connorwhite-online/touch-mic/hardware/renders/gummy-top.png

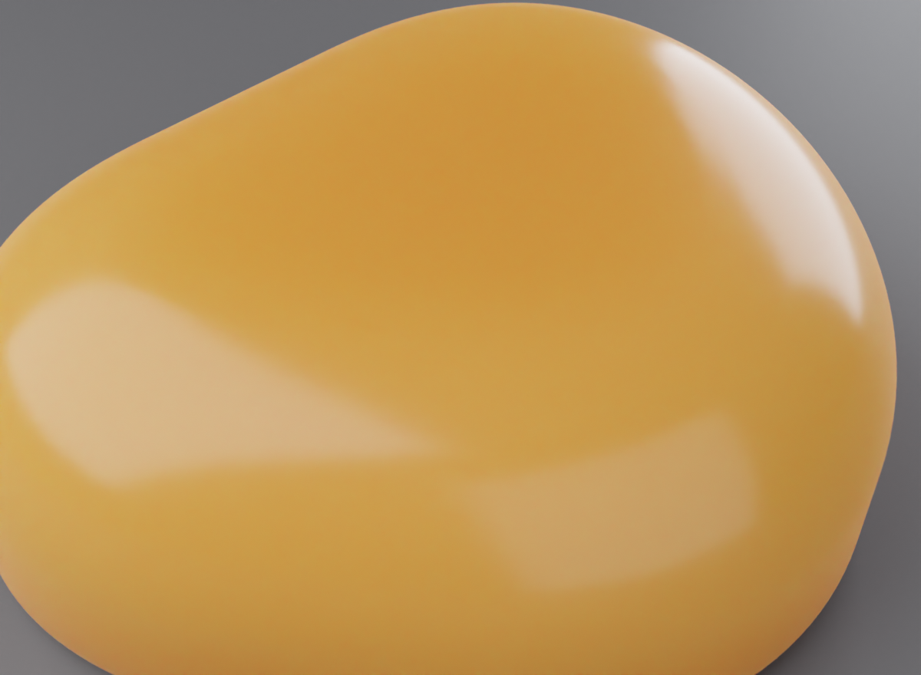
hardware/renders/gummy-top.png
