connorwhite-online/touch-mic/hardware/renders/pad-iso.png

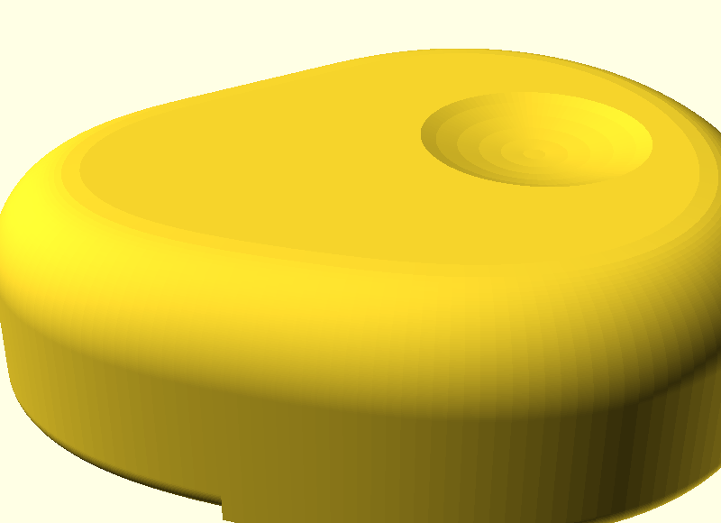
hardware/renders/pad-iso.png
