connorwhite-online/touch-mic/hardware/renders/gummy-hero.png

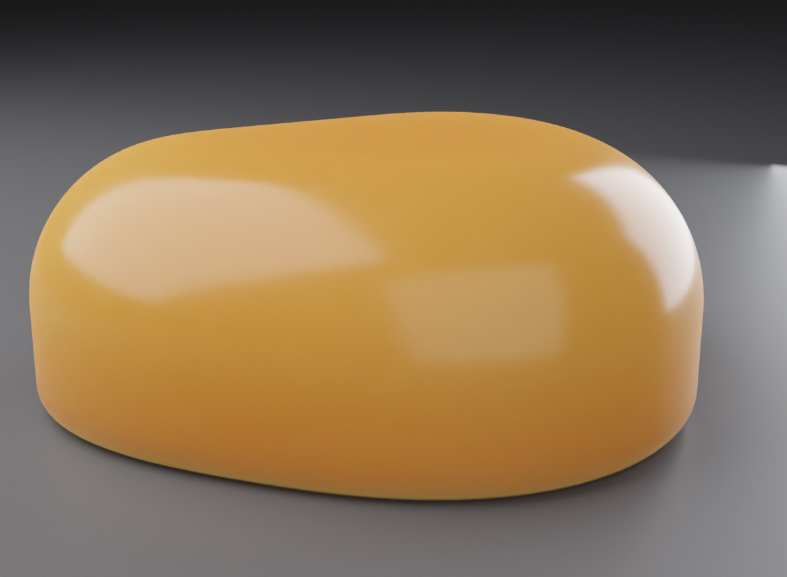
hardware/renders/gummy-hero.png
