connorwhite-online/touch-mic/hardware/renders/gummy-low.png

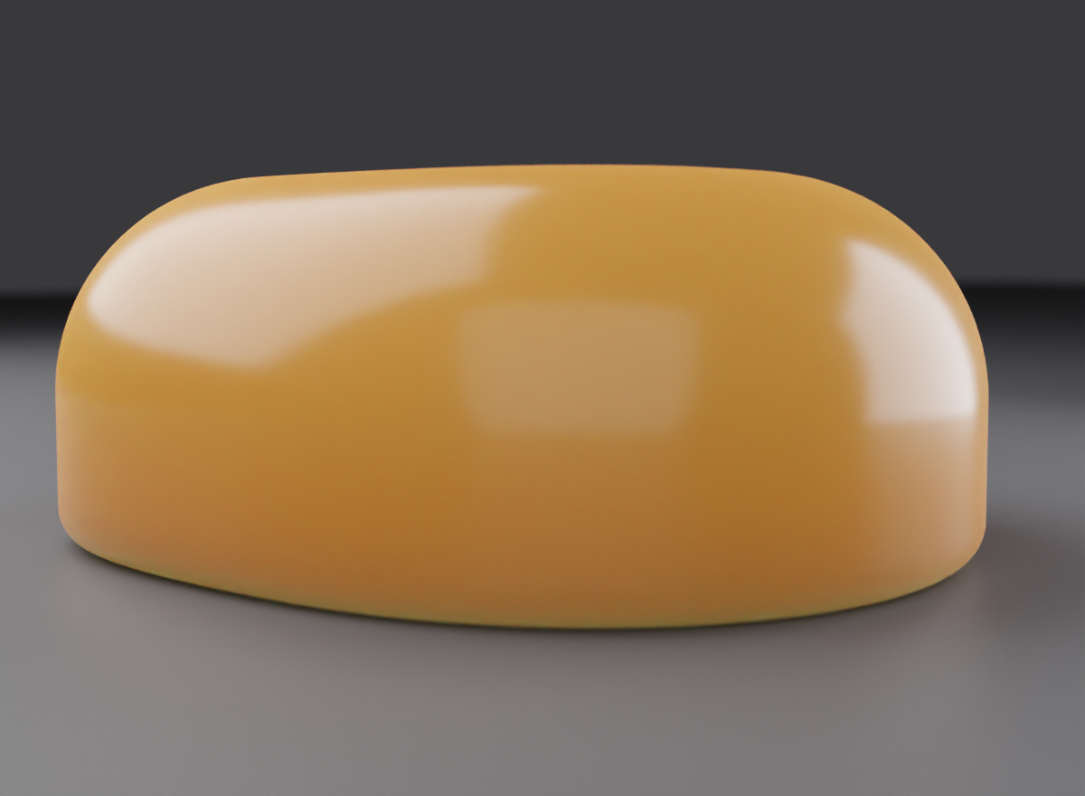
hardware/renders/gummy-low.png
