connorwhite-online/touch-mic/hardware/renders/layout-iso.png

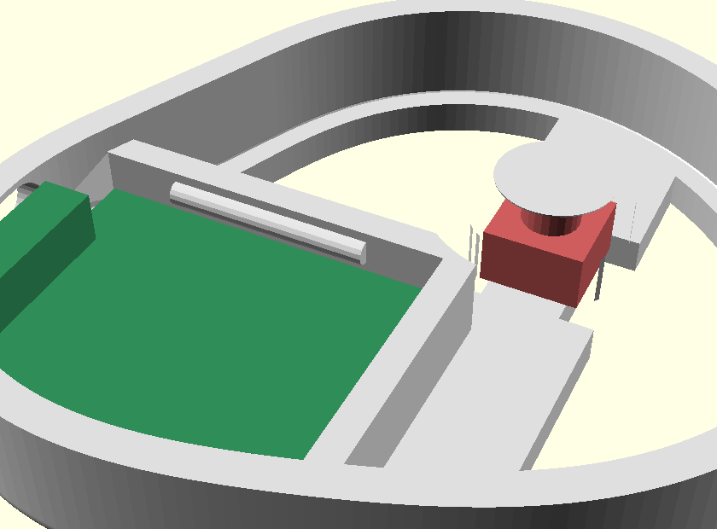
hardware/renders/layout-iso.png
