connorwhite-online/touch-mic/hardware/renders/layout-top.png

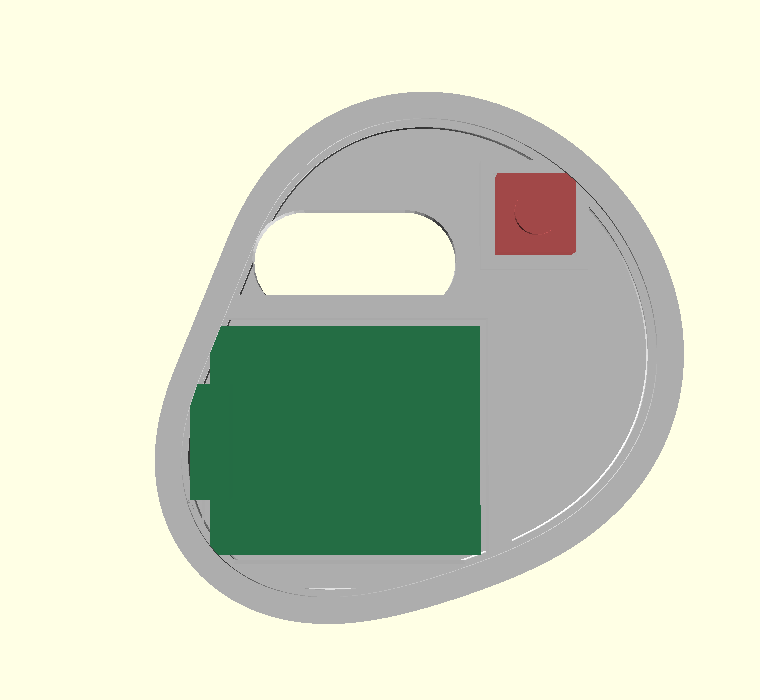
hardware/renders/layout-top.png
