connorwhite-online/touch-mic/hardware/renders/pad-section.png

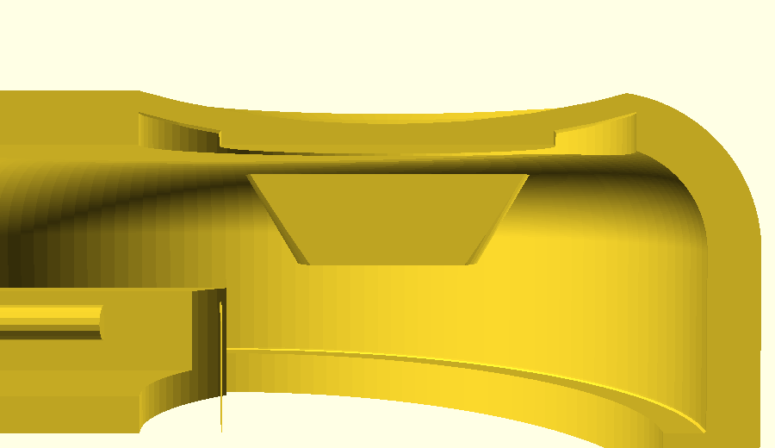
hardware/renders/pad-section.png
