connorwhite-online/touch-mic/hardware/renders/satin-hero.png

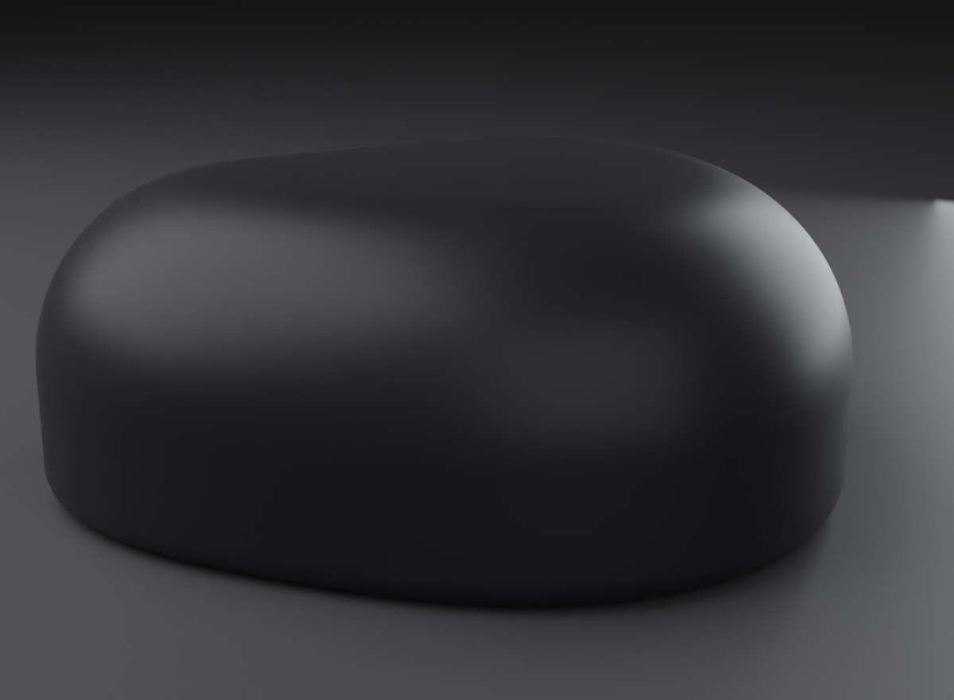
hardware/renders/satin-hero.png
