connorwhite-online/touch-mic/hardware/renders/sec-x.png

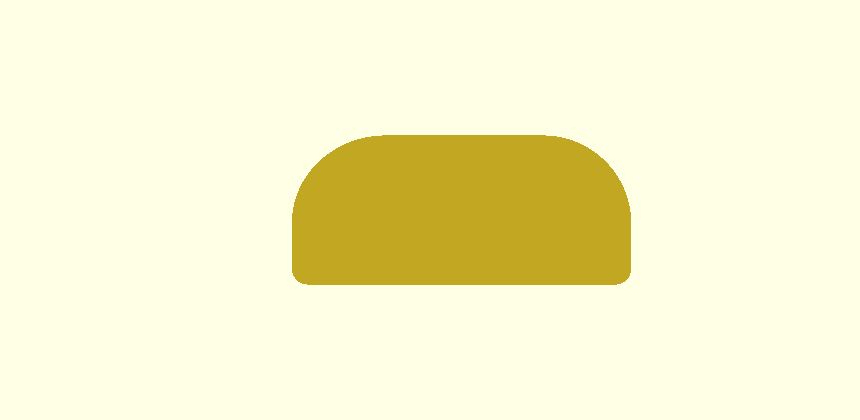
hardware/renders/sec-x.png
