connorwhite-online/touch-mic/hardware/renders/underside.png

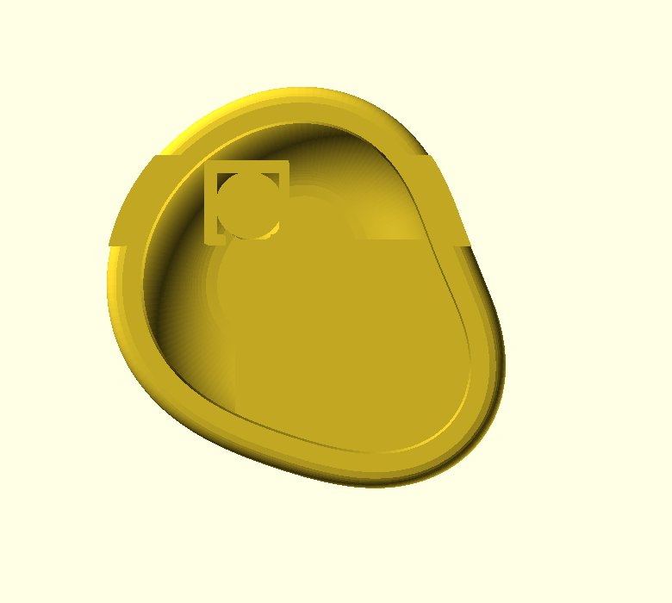
hardware/renders/underside.png
