connorwhite-online/touch-mic/hardware/renders/usb-flank.png

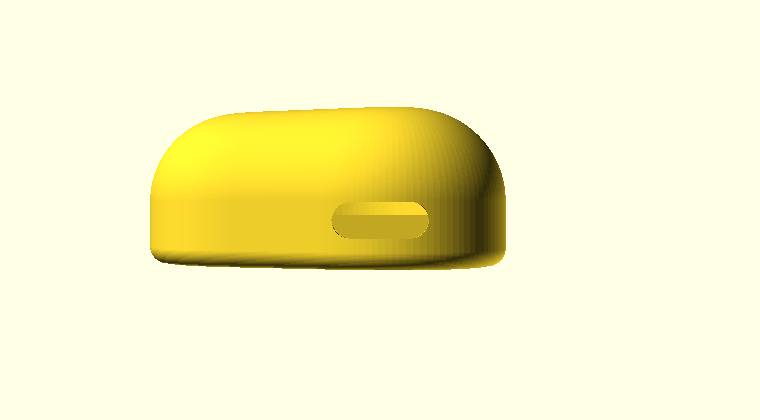
hardware/renders/usb-flank.png
