connorwhite-online/touch-mic/hardware/datasheets/TS02-66-50-BK-100-LCR-D.step

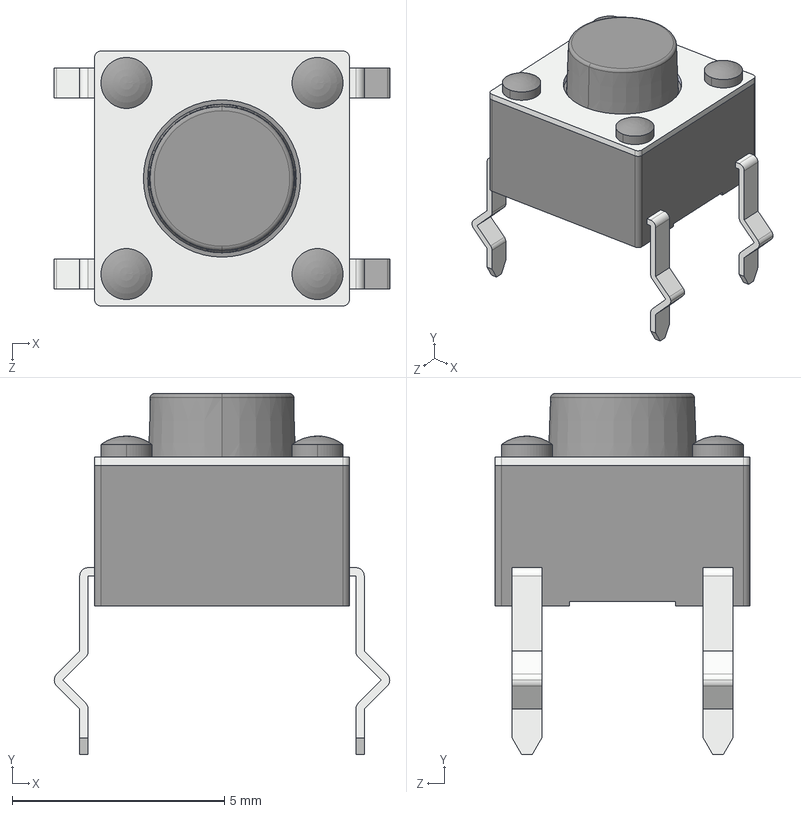
[picture p12: CAD file, 2026-10-24]
hardware/datasheets/TS02-66-50-BK-100-LCR-D.step
7.90 x 8.50 x 6.00 mm
