connorwhite-online/touch-mic/hardware/stl/body.stl

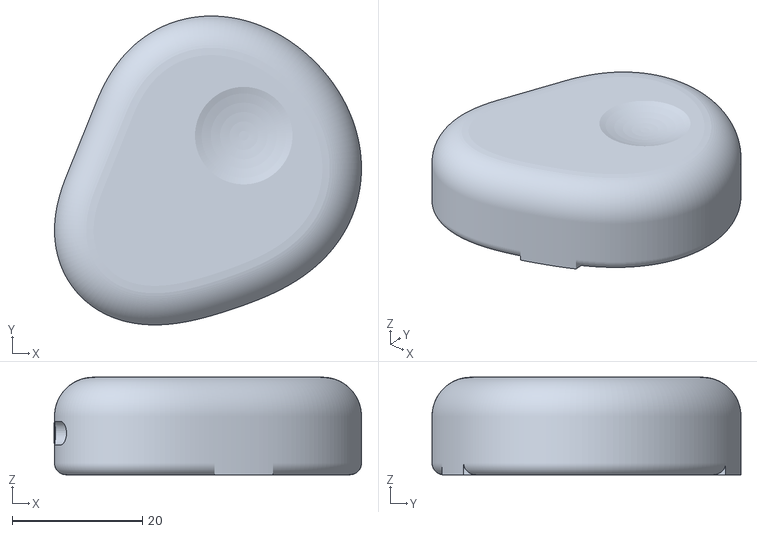
[picture p13: CAD file, 2026-10-24]
hardware/stl/body.stl
47.1 x 47.4 x 15.0
