connorwhite-online/touch-mic/hardware/stl/gummy.stl

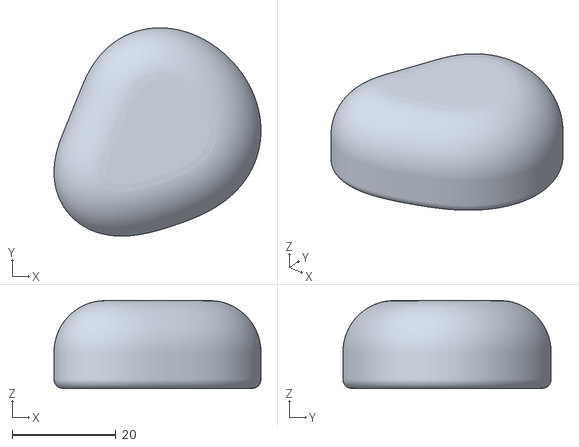
[picture p14: CAD file, 2026-10-23]
hardware/stl/gummy.stl
39.9 x 40.2 x 17.0
