connorwhite-online/touch-mic/hardware/stl/form.stl

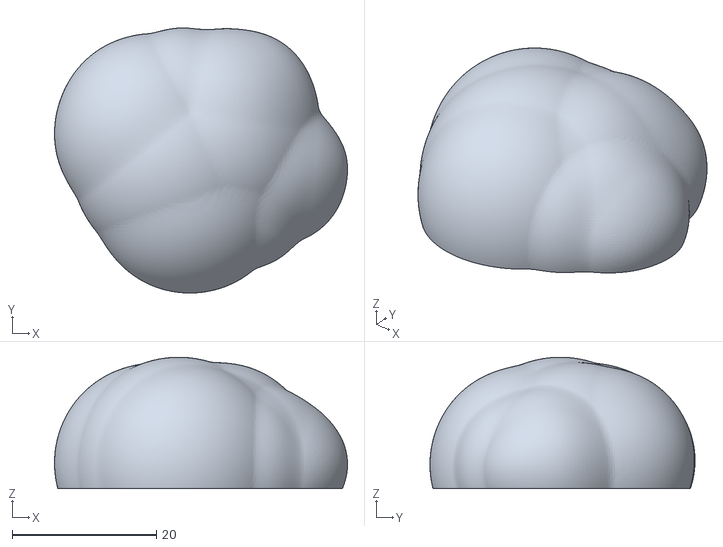
[picture p15: CAD file, 2026-10-23]
hardware/stl/form.stl
40.6 x 36.7 x 18.2
