connorwhite-online/touch-mic/hardware/stl/press.stl

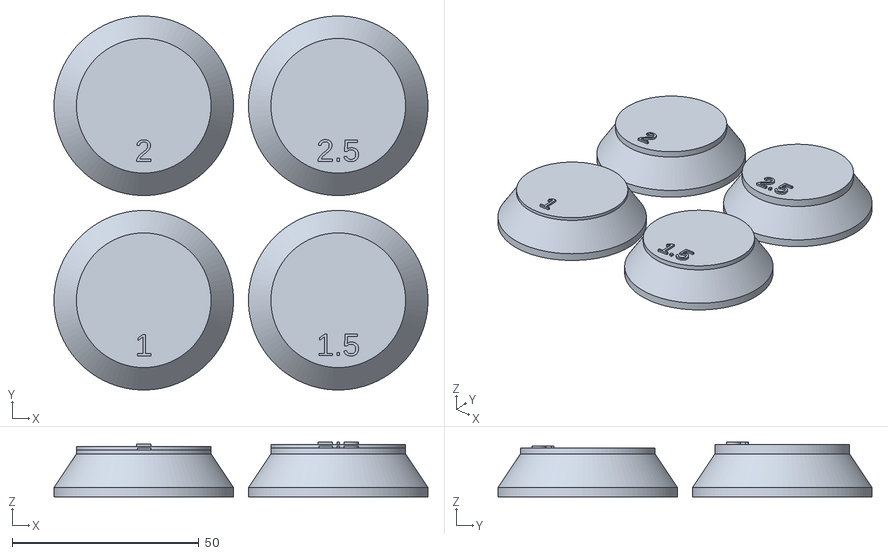
[picture p16: CAD file, 2026-10-23]
hardware/stl/press.stl
100.0 x 100.0 x 14.6
