connorwhite-online/touch-mic/hardware/stl/reach.stl

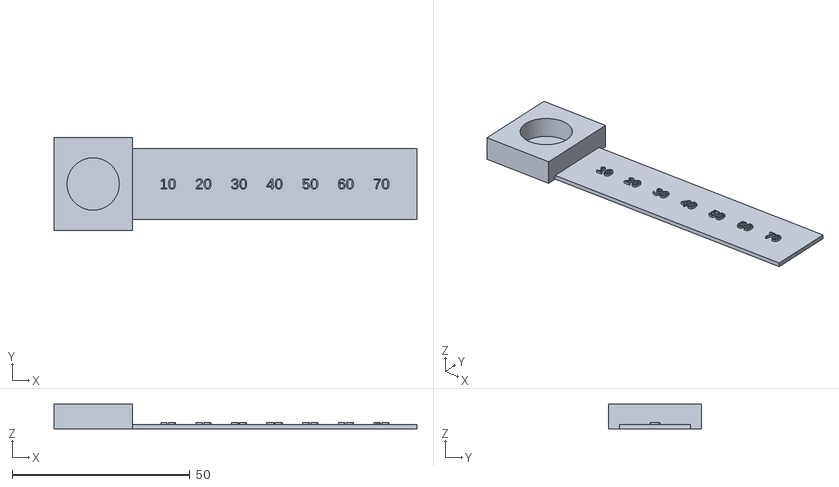
[picture p17: CAD file, 2026-10-23]
hardware/stl/reach.stl
102.0 x 26.0 x 7.00
