connorwhite-online/touch-mic/hardware/stl/puck.stl

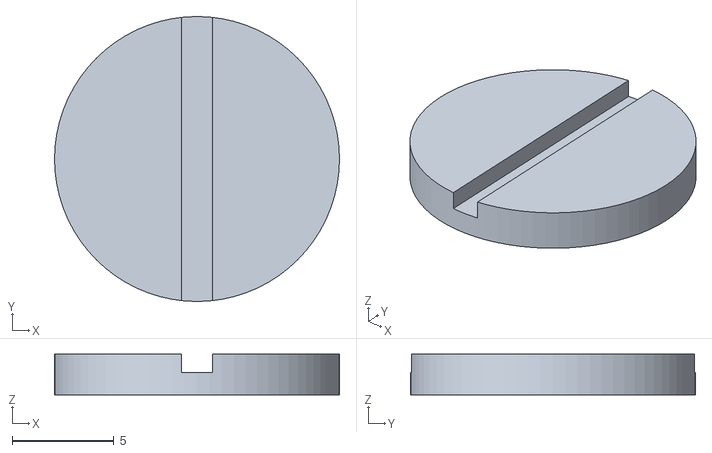
[picture p18: CAD file, 2026-10-23]
hardware/stl/puck.stl
14.0 x 14.0 x 2.00
