connorwhite-online/touch-mic/hardware/stl/ladder.stl

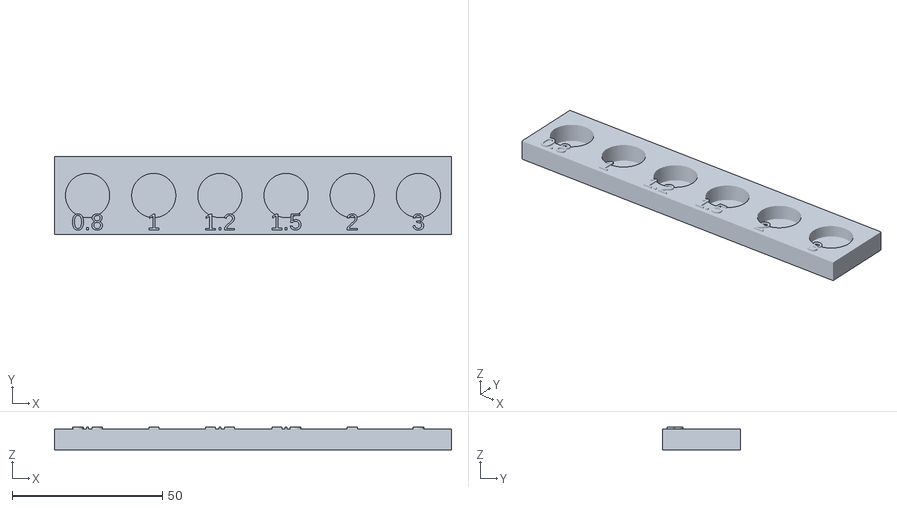
[picture p19: CAD file, 2026-10-23]
hardware/stl/ladder.stl
132.0 x 26.0 x 7.60
