connorwhite-online/touch-mic/(commit log)

2026-10-22 Initial commit: soft USB-C dictation button
    Host side works end to end: Hammerspoon presses Claude's own dictation
    control via the macOS Accessibility API, in the current conversation,
    with both tap and press-and-hold gestures.
    - firmware/ CircuitPython for XIAO SAMD21, holds F13 while touched,
    with live telemetry for tuning the electrode
    - host/ Hammerspoon config, plus the dead-end config-key script
    kept for the record
    - hardware/ Two-part BOM with sourcing links and open risks
    - docs/ Decision log and research, verified vs unverified split
    No hardware built yet.
2026-10-22 Add parametric test rig; replace foam electrode with a printed one
    The electrode is now a file rather than a sourced part. Foam works
    electrically but ships as sheets, so it has to be cut, which makes the
    electrode geometry vary between builds and stops published tuning
    numbers transferring to anyone else.
    - hardware/test-rig.scad: wall-thickness ladder (0.8-3.0mm), electrode
    puck, and a reach tongue for measuring how far 'touch anywhere'
    actually carries. All three render clean in OpenSCAD.
    - hardware/BOM.md: rewritten around one board, two printed files, a wire
    - docs/DECISIONS.md: records the reversal and why
2026-10-23 Replace capacitive sensing with a tactile switch
    The premise was never examined: the device only needs to know it is being
    touched, and a switch answers that with a 10-cent commodity part. This
    deletes the electrode entirely, and with it the sourcing problem, the
    triboelectric risk, the moisture drift, the calibration, and the conflict
    between 'conductive' and 'SLS TPU'.
    The body is now plain one-piece SLS TPU, which is what it wanted to be.
    - test-rig.scad: adds part="press", four shell-on-skirt cells with
    plungers, for finding the disc thickness that actuates from any point
    including the rim
    - BOM.md: rewritten around board + switch + one print
    - DECISIONS.md: records why capacitive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
2026-10-23 Add metaball form study: small chunky gummy, 41.5 x 40.5 x 19.3mm
    hull() of spheres cannot be smooth - a convex hull genuinely has ruled
    surfaces and flat triangular patches between lobes, and no amount of $fn
    removes them. Switched to BOSL2 metaballs, which blend as a scalar field.
    Two tuning traps worth recording:
    - with no influence cutoff, summed balls hold the field above the
    isovalue out to the bounding box, and the result renders as a solid box
    - too generous a cutoff merges everything into a sphere and inflates the
    surface well past the sphere radii
    body.scad still carries the hull-based internals and is superseded for
    form; internals need porting onto the metaball shell.
2026-10-23 Form: pillowy uneven lobes, 40.6 x 36.7 x 18.2mm
    Looked at Terra directly rather than working from text descriptions.
    Pulled three things from it: a lower profile, one dominant mass instead
    of a ring of equals, and a low broad lobe that spreads the base so the
    form reads as settled under its own weight.
    cutoff_k lowered to 2.5 so lobes stay legible as separate swells - at
    3.0 they melt into a single sphere, at 2.1 they read as a caterpillar.
2026-10-23 Port internals onto the metaball form; add studio renders
    body.scad now shells the blob with two isovalues and carries the plunger,
    board cradle, USB aperture, waist flexure and service slot.
    You cannot offset an implicit surface uniformly, so the wall varies with
    the field gradient - measured 2.73mm at the crown, 1.94mm at the flanks.
    That suits the design: a stiff crown transmits an edge press to the
    plunger instead of denting, and the thin flank is where the waist wants
    to be.
    Verified by measurement rather than eye: plunger spans Z 7.30-14.92 and
    lands 0.8mm above the switch; cavity is 36.6 x 33.6mm at board height
    against ~29mm needed; base flare peaks at 13.8 deg from vertical, so it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
2026-10-23 Replace metaball form with a drawn one
    Metaballs produce an emergent surface - nobody draws it, so it reads as
    blended spheres rather than a designed object.
    Second attempt, hulled 2D circles, was also wrong: a convex hull is arcs
    joined by straight tangents, so adding circles adds facets. It came out
    a polygon.
    gummy.scad builds the plan from a smooth radial function - a constant
    plus three low-order harmonics. Continuous by construction, so there is
    no facet at any resolution, while the harmonics give tunable asymmetry
    (plan radius ranges 14.5 to 23.2mm, ratio 1.60).
    Section is a single edge language: 1.8mm base radius, 5.2mm straight
    flank, 10mm top roll. 39.9 x 40.2 x 17.0mm.
    Interna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
2026-10-23 Port internals onto the drawn form; fix the double USB aperture
    The USB cut was a 90mm cylinder starting outside the part, so it punched
    straight through and left a second slot on the opposite flank. It now
    starts 1.5mm outside and runs wall+6, stopping inside the cavity.
    Verified from both flanks: one aperture, far side clean.
    Mounting is now explicit instead of implied:
    - board bay, three walls plus an open end so the USB-C connector
    overhangs into the aperture rather than fighting a wall
    - square seat that locates the switch without burying it
    - plunger hanging from the crown directly over that seat
    Clearance between the bay and the seat was 0.4mm, which would fuse in
    SLS. Switch move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
2026-10-23 Open the underside; carry the switch on a bridge
    The closed floor made the thing unassemblable - a 21mm board cannot pass
    an 8mm service slot. The underside is now open apart from a perimeter
    rim, which is also the powder escape SLS needs.
    That exposed the real constraint: the plunger pushes DOWN on the switch,
    so the switch needs backing from below, but the only access is from
    below. A fully open underside has no load path.
    Resolved with a bridge - a bar spanning rim to rim under the switch,
    anchored at both ends. The switch pocket is open toward the access
    aperture so it slides in from the side rather than passing through a
    floor. Everything else stays open for assembly.
    Access aperture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
2026-10-23 Target the focused pane; auto-send on hold-release
    Two problems with split views: a plain tree walk returns the first
    dictation control in tree order, so with a project chat and a thread
    side by side it always picked the same pane regardless of where the
    user was typing. findControl now starts from AXFocusedUIElement and
    climbs until an ancestor contains a dictation control.
    Sending no longer needs the keyboard. There is a send button in the
    accessibility tree - 'Send' in the Code tab, 'Send message' in chat -
    so pressing it directly works even when Claude is not frontmost, which
    matters because the script deliberately never steals focus. Exact-match
    sets keep 'Send feedback' out of it.
    Ho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
2026-10-23 Target the focused pane, auto-send on hold, stop searching from the root
    Three things, all surfaced by the split-view question.
    Pane targeting: findControl took the first match in tree order, so with a
    project chat and a thread side by side it always picked the same pane
    regardless of where the user was typing. It now climbs from
    AXFocusedUIElement and searches only near the composer.
    Sending: there is a send button in the tree - 'Send' in Code, 'Send
    message' in chat - so Return never needs hijacking, and pressing the
    button works even when Claude is not frontmost. The button does not
    exist while the composer is empty; it appears with the text, so it is
    looked up after the transcript sett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
2026-10-23 Pad with a stiff piston and thin hinge ring; drop the waist flexure
    Form is now a chunky pad: 47.1 x 47.4 x 15.0mm, flat-ish top (R_top 6),
    with a gently indented touch area inboard of the edge.
    The outer skin is CONTINUOUS - no slots, no gaps. All flexure is
    thickness varied from the inside, in three zones: 1.8mm over the pad so
    it moves as a piston rather than bowing, 0.8mm over a ring around it
    which is what actually bends, 2.0mm beyond that as a rigid surround.
    The pad funnels down to a short plunger sitting 0.3mm off the switch.
    This replaces the waist flexure and removes its two worst problems: the
    whole shell no longer has to move, so an edge press cannot tilt it, and
    a knock on the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
2026-10-23 Add switch leg relief; stop the rim cut deleting the bridge
    Two faults found by rendering the internals with the parts in place.
    The switch was floating. The rim opening spans z -1 to floor_t, exactly
    where the bridge sits, so the cut that opens the underside was removing
    the bridge carrying the switch. The board bay survived only because its
    shelf sits just above that cut. The bridge is now unioned after the
    subtraction, like the plunger.
    Through-hole legs protrude ~3.5mm below the switch body and had nothing
    to seat into - the switch would have bottomed out on the bridge. Slots
    now pass the pins into the open underside, which also means the wires
    can be soldered with the switch already s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
2026-10-23 BOM: final parts with Digi-Key links
    Both parts are on Digi-Key so it is one order. Seeed does not sell
    discrete tactile switches, and Digi-Key is an authorised Seeed
    distributor, so the XIAO is there too - the reverse is not possible.
    Seeed's own US warehouse page excludes the XIAO series from free
    shipping and points customers at US distributors anyway.
    Records why force beat height on the switch: the 4.30mm variant matches
    the CAD exactly but only exists at 160 gf, while height is free here and
    force is not. Also records the rejected options and why, so they are not
    revisited.
    Flags the two numbers inferred from the series norm rather than a
    datasheet - pin span and the body/actuator sp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
2026-10-24 Switch dimensions from the manufacturer STEP, not inference
    The STEP corrected three numbers I had guessed or mis-read.
    Body is 6.7 x 6.0 across the terminal roots, not 6.0 square. The seat
    pocket was 6.5 square, so the switch would not have seated at all.
    Actuator is 5.0mm off the seating plane, not 5.50 - the part number key
    reads -50- as 5.0mm and the 5.50 came from a search summary rather than
    the manufacturer. With the body top at 3.5 that leaves 1.5mm of stem,
    not the 2.0 assumed.
    Leads reach 3.5mm below the seating plane, not ~2.9 as estimated from
    the overall height, and sit at +/-3.55 and +/-2.33 rather than on the
    6.5mm hole pattern. Relief slots re-centred to suit.
    STEP commit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
